ro-sat-one-association/C4TS/README.md

# C4TS
https://www.facebook.com/c4tsinspace/
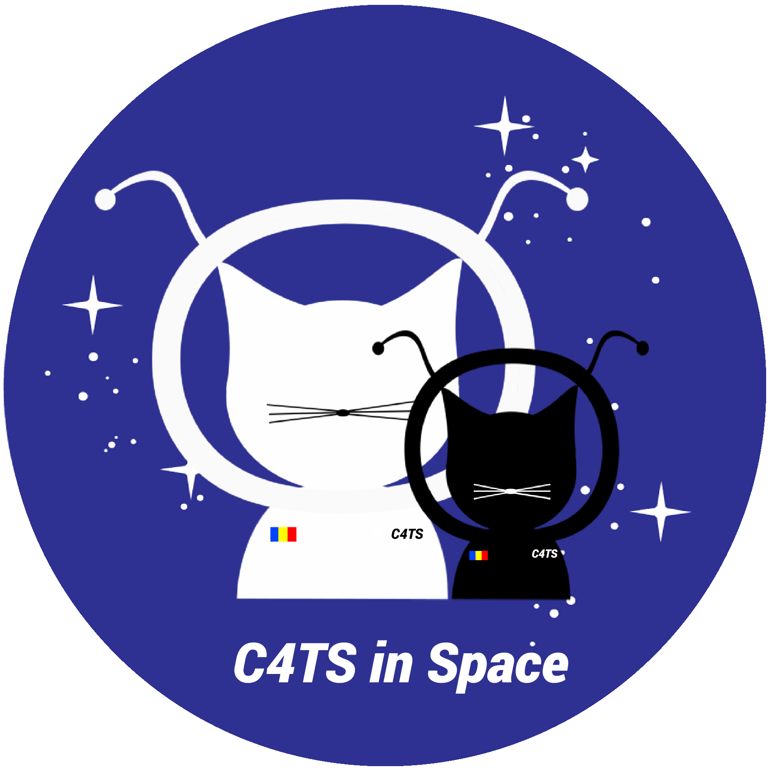
[picture p1: logo.png]
