ro-sat-one-association/C4TS/checklisturi finale/Prelansare.docx

# CHECKLIST PRE-LANSARE

1. Cameră video
2. Baterii camera
3. Setari făcute camera
4. Cameraman „permanent”
5. Telefon pentru live Facebook (Nico)
6. Delimitare loc lansare
7. Prelată (+fixare cuie)
8. Balon latex
9. Fixare gura de umplere balon + asigurare
10. Butelie cu He
11. Nacelă
12. Parașută
13. Legare nacelă de parașută
14. Legare linie de balon
15. Legare linie asigurare si determinare Nozzle Lift (cântar)
16. Verificare legături

Semnatura celui ce a facut verificarile și numele în clar:
