ro-sat-one-association/C4TS/checklisturi finale/inventar.docx

# INVENTAR GENERAL

Reductor de gaz
Gură de umplere balon
Furtun reductor-gură
Multimetru
Patent
Unealtă tăiere A-ȚĂ?!
APRSDroid (Daniel)
Raportoare mari
Elastic antenă
Busolă (Nico)
Hotspot mobil (Radu)
Laptop 1, 2, (3)
RTL-SDR Pi
RTL-SDR monitorizare
Reflectometru
Baofeng
GoPro
Cântar
Bandă teflon
Apă cu săpun
Apă
Semințe
Șlapi
Card cameră internă
Card cameră externă
Card GoPro
Incarcator USB
Cablu USB 1
Cablu USB 2
Prelungitor
HW Balon
Baterie principală balon
Rezervă baterie balon
Baterie GSM
Cameră internă Sony
Cameră externă
Folie alimentară
Coliere plastic
Legături nacelă-balon
Antena de pe balon-nacelă
Balon Latex
Parașută
Suport antenă
Butelie He
Prelată
Scaun x3
Masă
2 tăruși
Umbrelă
Generator
Antenă
