ro-sat-one-association/C4TS/checklisturi finale/Lansare.docx

# CHECKLIST LANSARE

1. Pornește hardware-ul balonului
2. Așteaptă de la stația de sol confirmarea primirii mesajelor APRS și SMS
3. Așteaptă de la stația de sol confirmarea funcționării corecte a senzorilor
4. Verificare robineți reductori He ( inchis)
5. Montare reductor
6. Deschidere robinet înalta presiune
7. Verificare etanseitate ( + corectare in caz că trebuie )
8. Conectare butelie He la gura de umplere
9. Deschidere robinet joasă presiune
10. Verificare etanseitate la furtune și la gura de umplere
11. Umple balonul cu He
12. Verificare Nozzle Lift
13. Etanșarea gurii balonului
14. Extragere gura de umplere
15. Finalizarea legaturii de etanșarea si reverificarea legaturii liniei de payload
16. Reconfirmare de la stația de sol a funcționării corecte a comunicațiilor și senzorilor
17. Lansează !

Semnatura celui ce a facut verificarile și numele în clar:
