ro-sat-one-association/C4TS/scheme/1.png

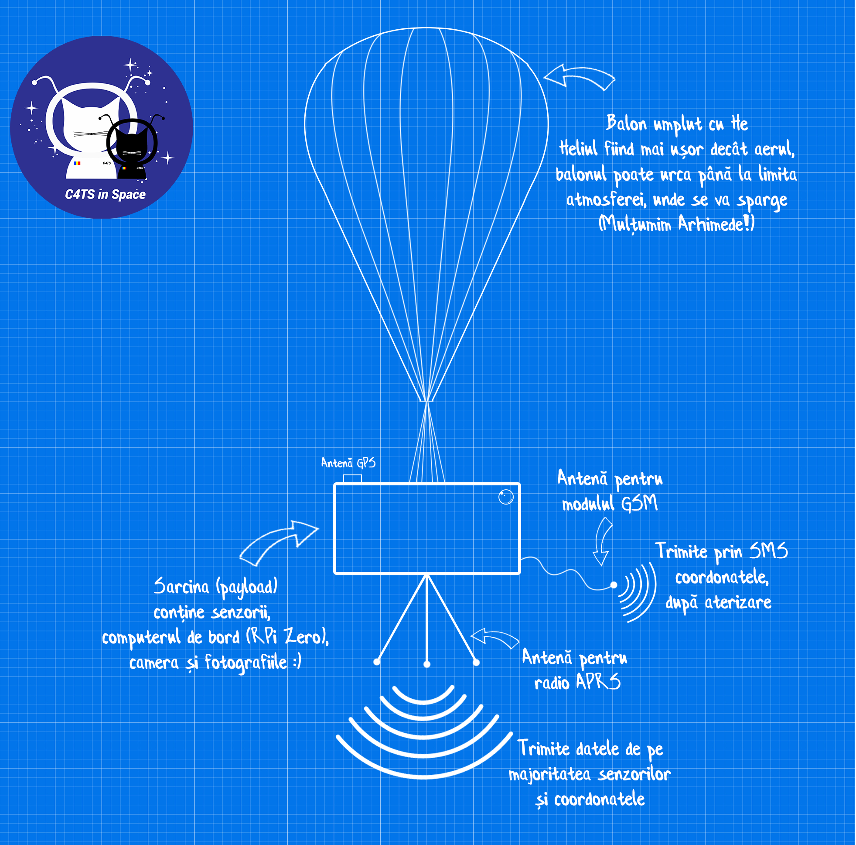
scheme/1.png
