ro-sat-one-association/C4TS/scheme/HABPCB/gsm-gpsb.png

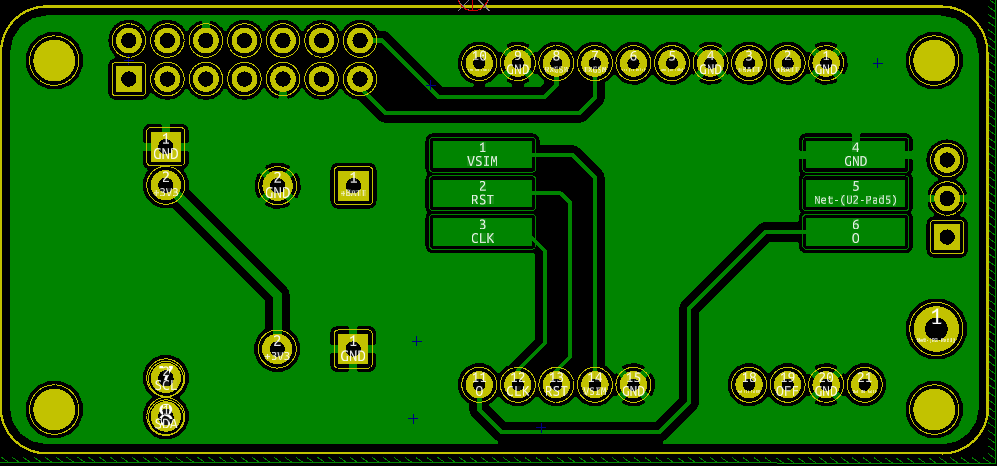
scheme/HABPCB/gsm-gpsb.png
