ro-sat-one-association/C4TS/scheme/HABPCB/gsm-gpsf.png

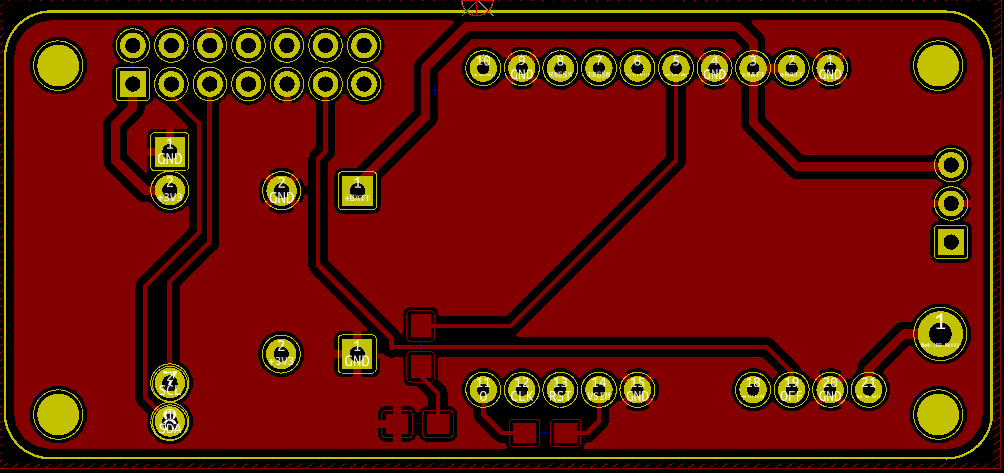
scheme/HABPCB/gsm-gpsf.png
