ro-sat-one-association/C4TS/scheme/HABPCB/promini hx1b.png

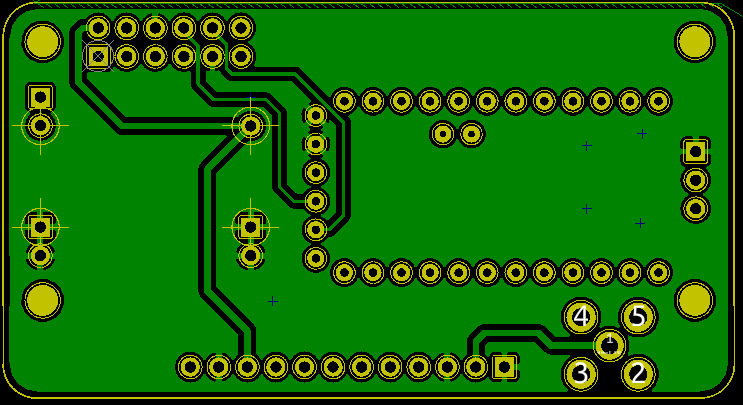
scheme/HABPCB/promini hx1b.png
