ro-sat-one-association/C4TS/scheme/HABPCB/promini hx1f.png

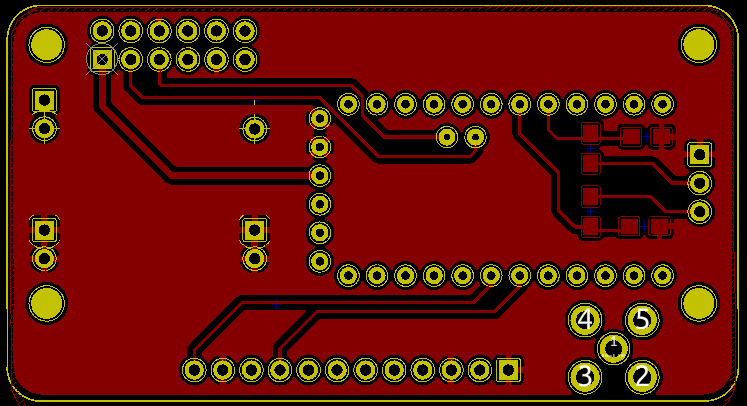
scheme/HABPCB/promini hx1f.png
