ro-sat-one-association/C4TS/scheme/HABPCB/sensorsb.png

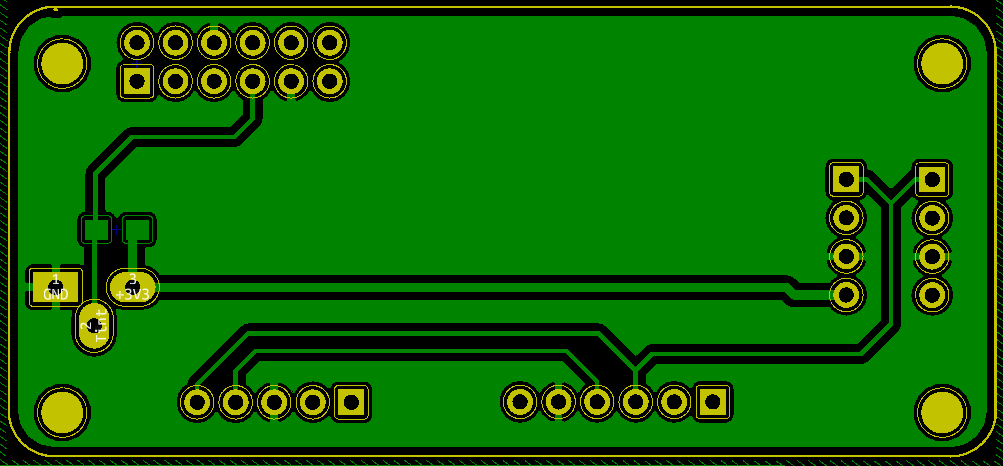
scheme/HABPCB/sensorsb.png
