ro-sat-one-association/C4TS/scheme/HABPCB/sensorsf.png

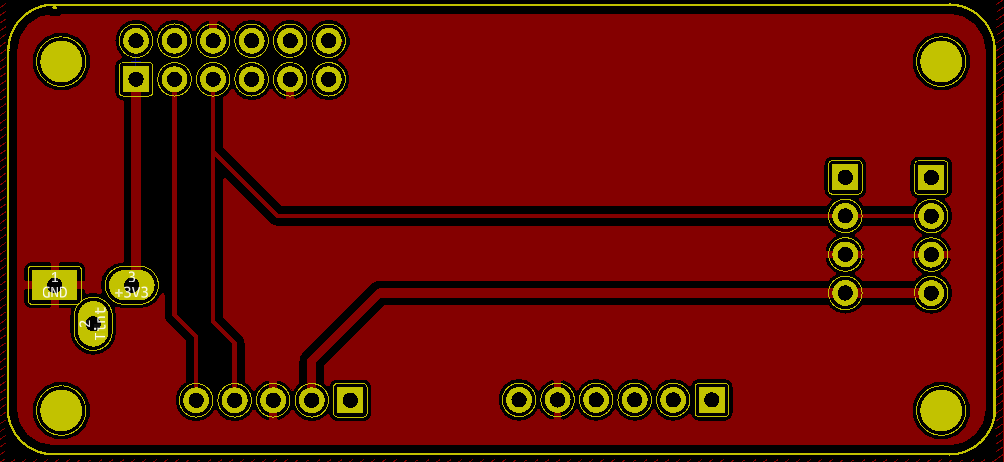
scheme/HABPCB/sensorsf.png
