ro-sat-one-association/C4TS/scheme/hardware.png

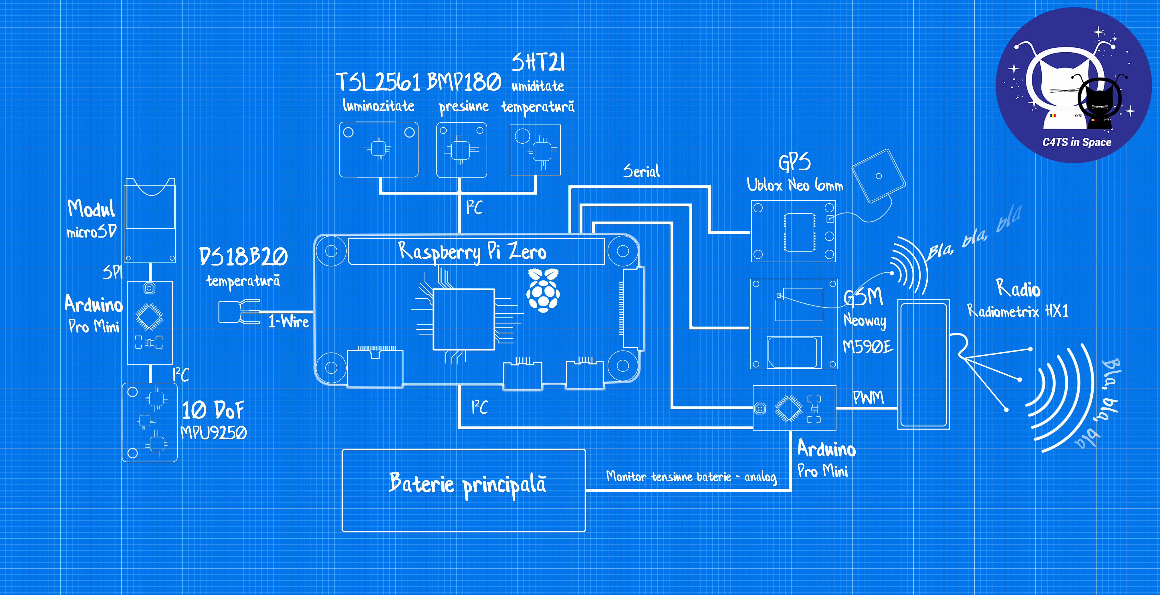
scheme/hardware.png
