ro-sat-one-association/C4TS/scheme/Noaptea cercetatorilor/1.png

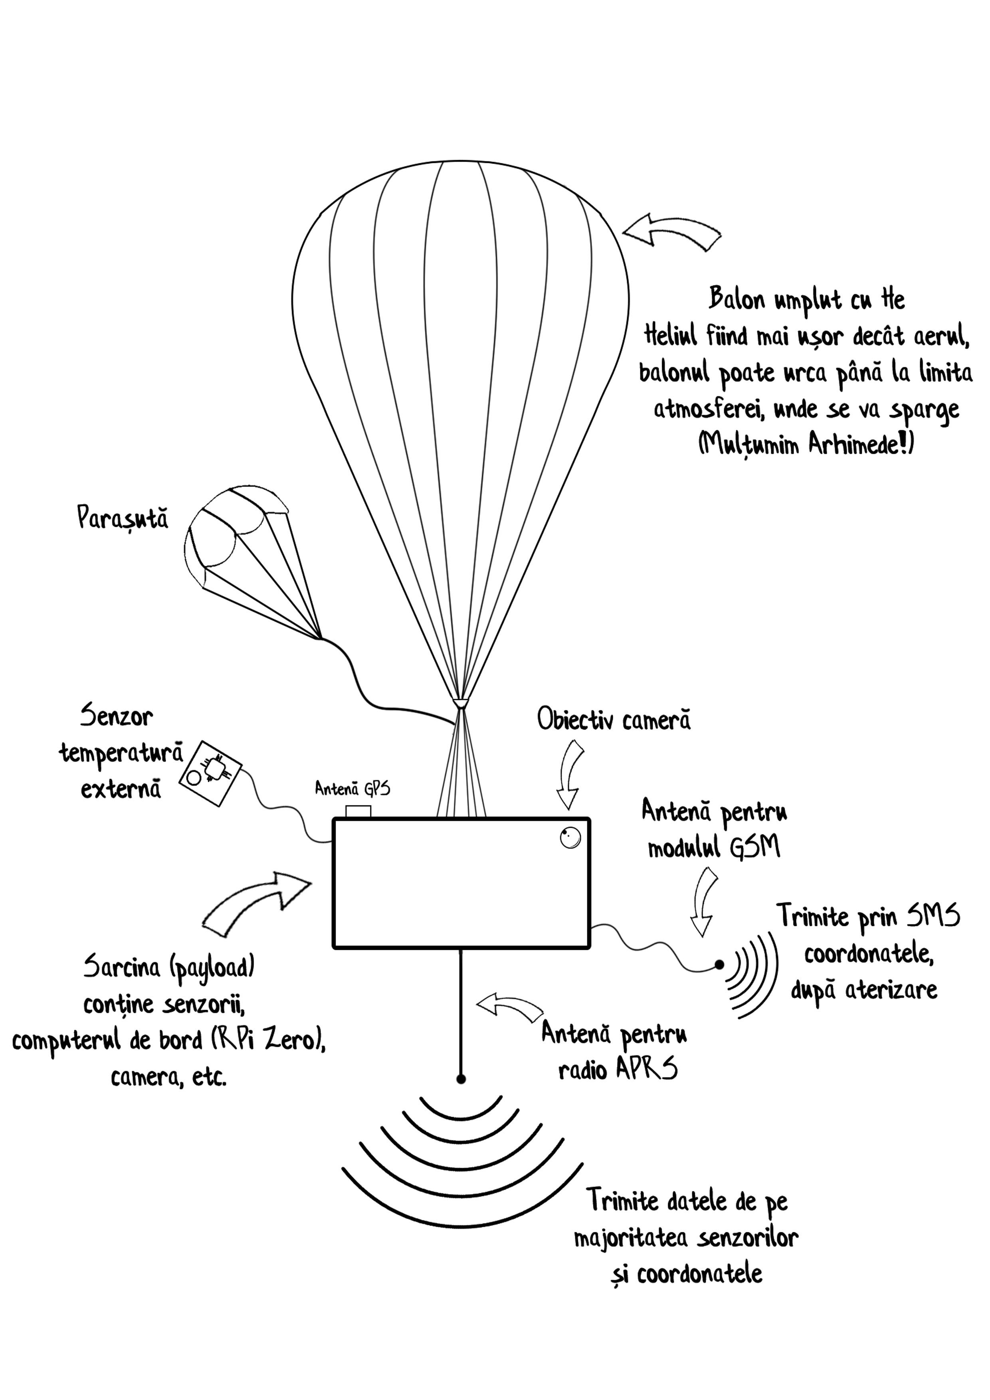
scheme/Noaptea cercetatorilor/1.png
