ro-sat-one-association/C4TS/scheme/Noaptea cercetatorilor/fata.png

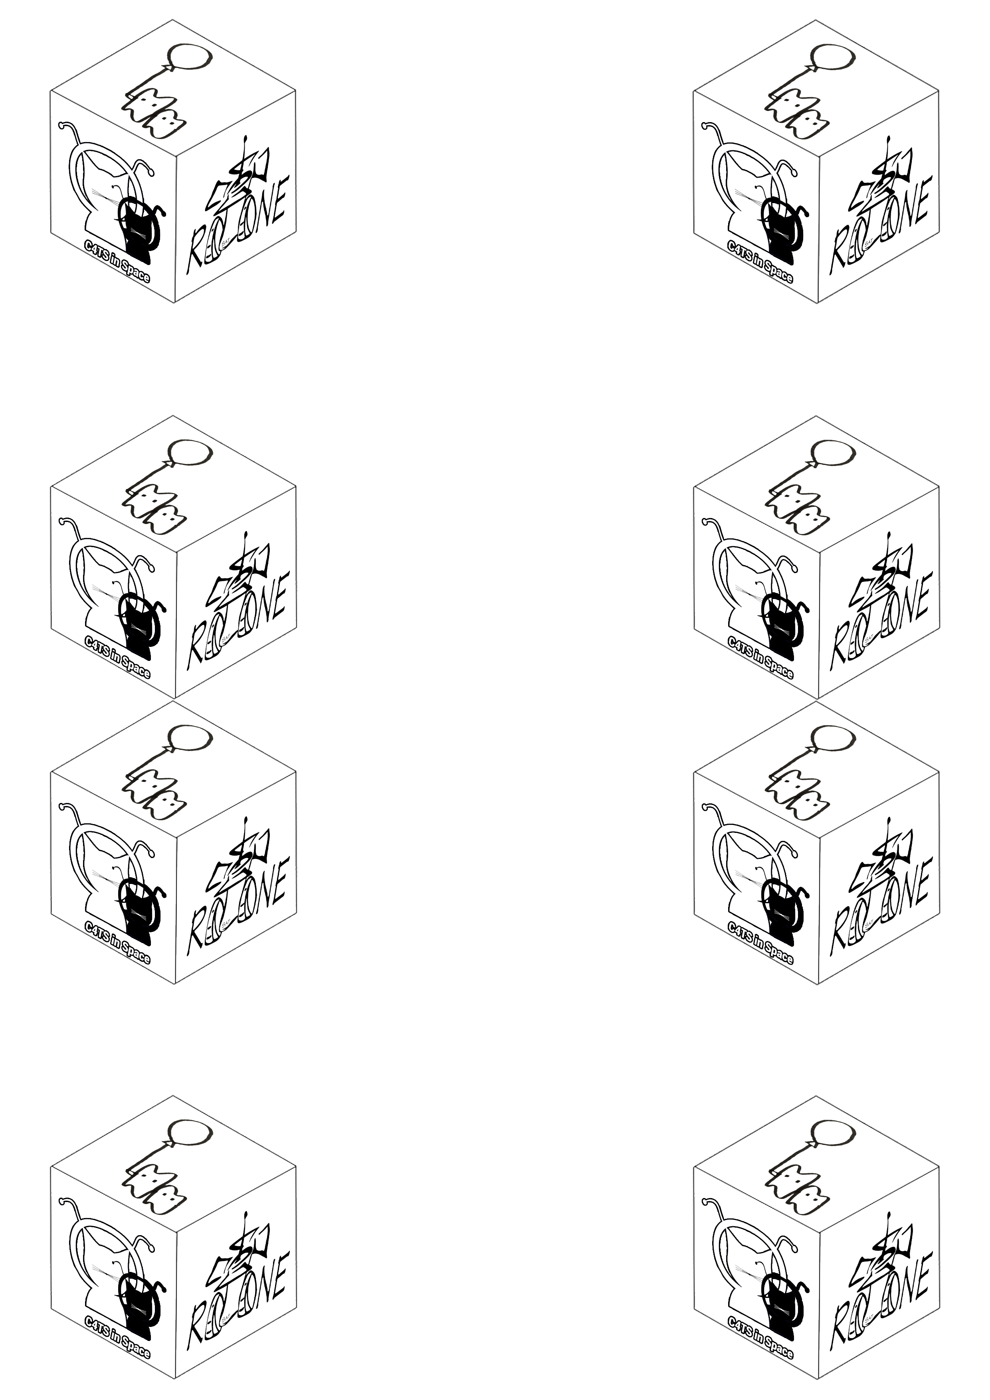
scheme/Noaptea cercetatorilor/fata.png
