ro-sat-one-association/C4TS/scheme/Noaptea cercetatorilor/hard.png

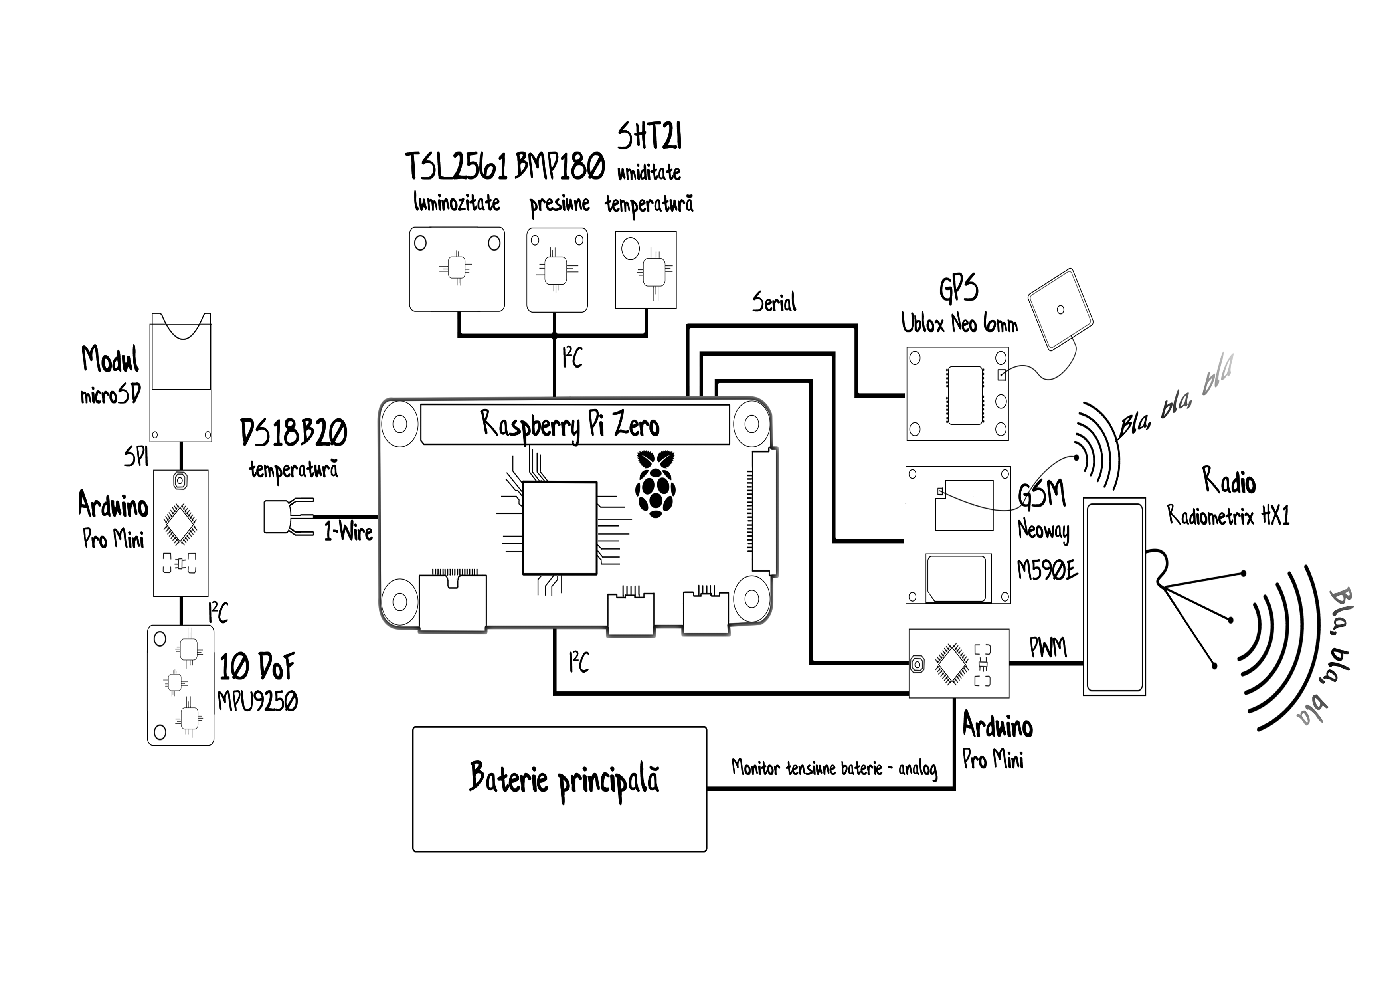
scheme/Noaptea cercetatorilor/hard.png
