ro-sat-one-association/C4TS/scheme/placi/gsm-gpsf.png

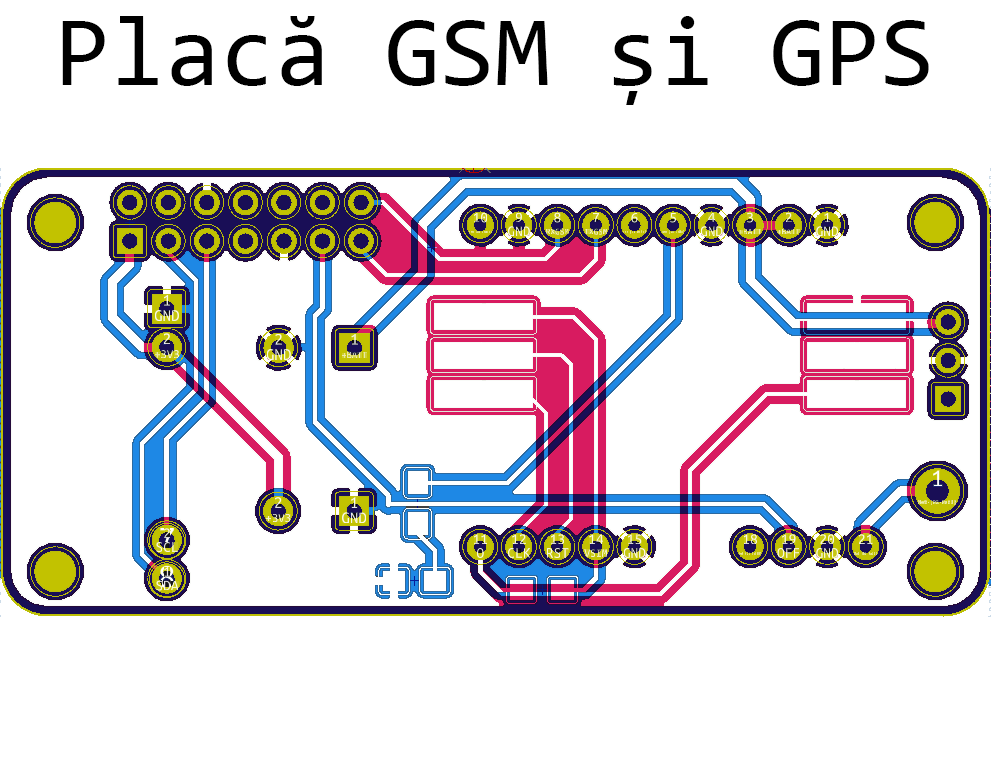
scheme/placi/gsm-gpsf.png
