ro-sat-one-association/C4TS/scheme/placi/promini hx1f.png

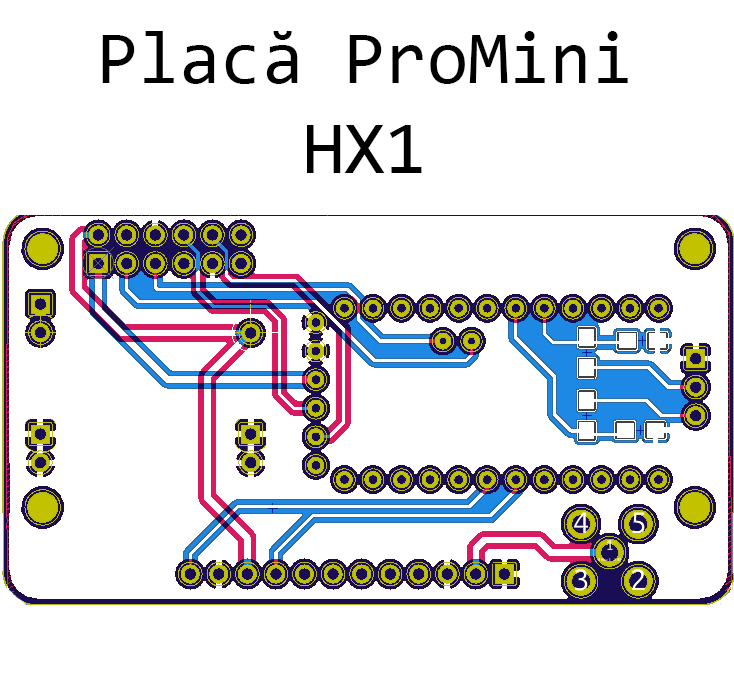
scheme/placi/promini hx1f.png
