ro-sat-one-association/C4TS/scheme/schema detaliata cod.png

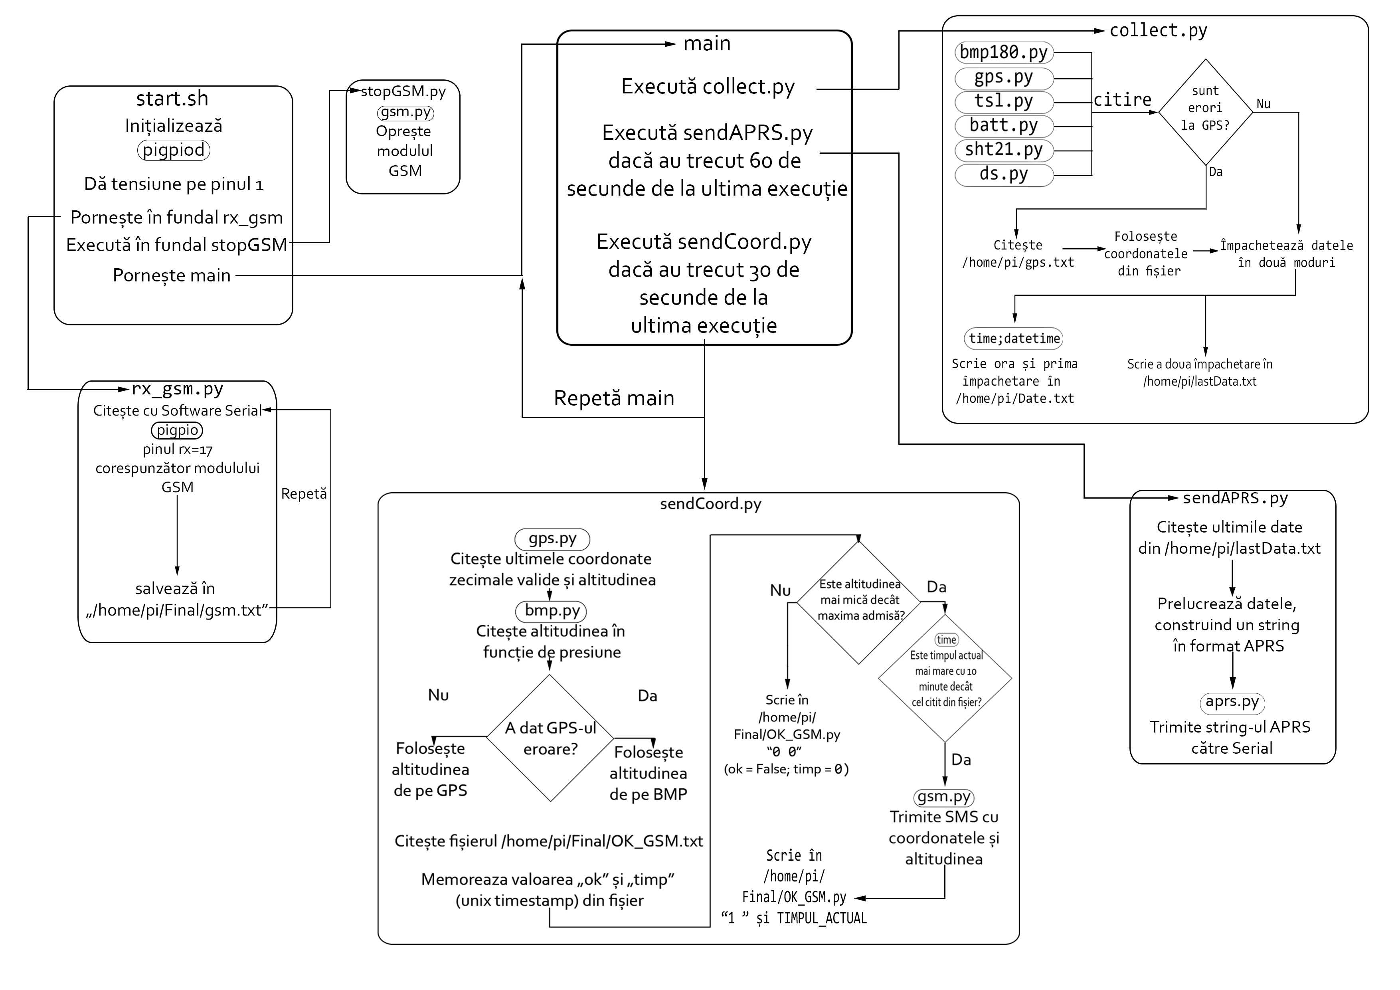
scheme/schema detaliata cod.png
