ro-sat-one-association/C4TS/scheme/schema_comunicatii.png

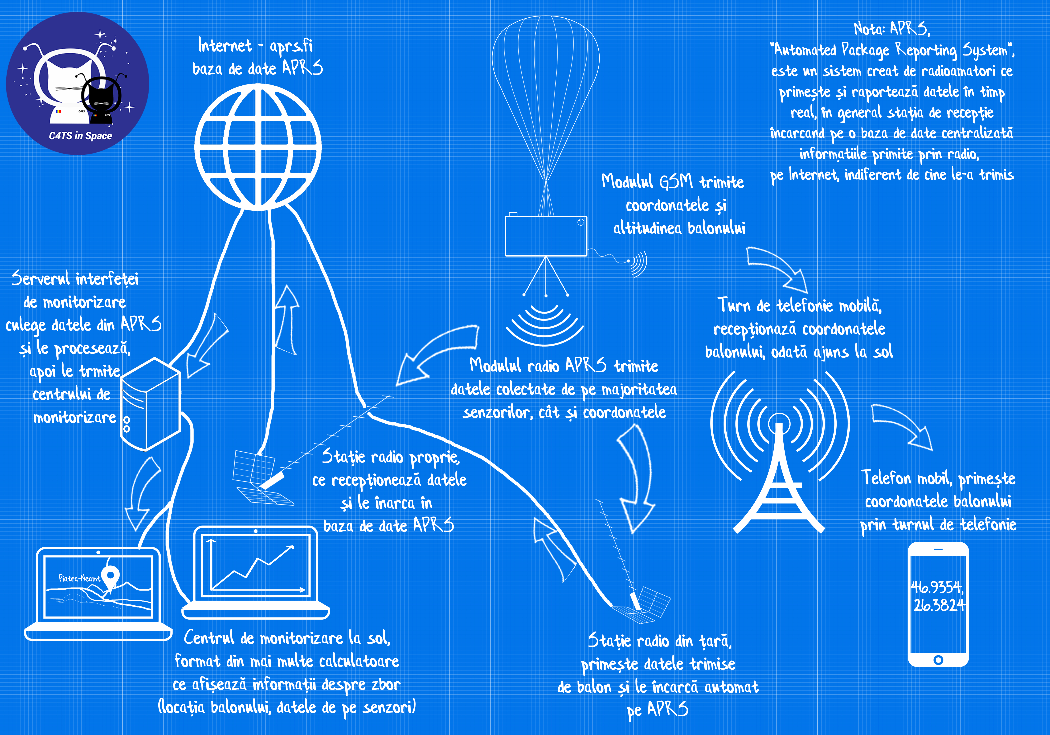
scheme/schema_comunicatii.png
