ro-sat-one-association/C4TS/tracker/tracker.kicad_pcb

## KiCad design tracker/tracker.kicad_pcb (2018-05-26, last stored version)

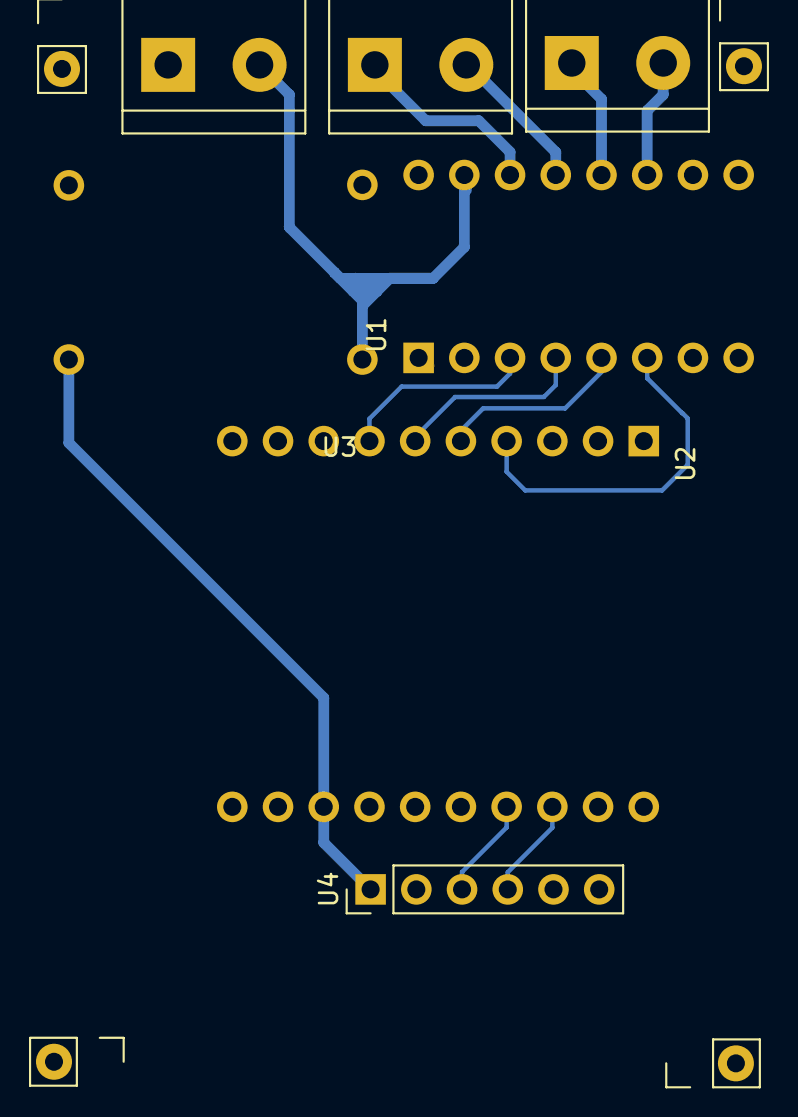
[picture p30: board tracker.kicad_pcb from above]

Board: 2 copper layers, 7 parts (0 on the bottom side), 13 nets.

Parts:
J1: Conn_01x02; TerminalBlock_bornier-2_P5.08mm
M1: Motor_DC -A-; TerminalBlock_bornier-2_P5.08mm
M2: Motor_DC2 -B-; TerminalBlock_bornier-2_P5.08mm
U1: DRV8833
U2: ESP8266(3.3); ESP8266
U3: pwr_reg
U4: M10DOF; Pin_Header_Straight_1x06_Pitch2.54mm

Connections:
+3V3: U2.19, U3.4, U4.1
+BATT: J1.2, U1.15, U3.1
GND: J1.1, U1.16, U2.10, U2.17, U2.18, U3.2, U3.3, U4.2
unnamed: M1.1, U1.12
unnamed: M1.2, U1.11
unnamed: M2.1, U1.14
unnamed: M2.2, U1.13
unnamed: U1.3, U2.7
unnamed: U1.4, U2.6
unnamed: U1.5, U2.5
unnamed: U1.6, U2.4
unnamed: U2.23, U4.3
unnamed: U2.24, U4.4
