ro-sat-one-association/C4TS/(commit log)

2017-11-03 RPi -> Arduino Pro Mini Driver -> APRS Radio
2017-11-05 Basic driver changes
2017-12-19 cripturi de camera:{
2018-01-28 Monitorizare baterie + Driver radio
2018-02-03 Driver functional
2018-03-05 Procedura de verificare a senzorilor la pornire + APRS
2018-03-05 + Camera check
2018-03-26 Tracker + Cod Busola MPU + SoftwareSerial Rx/Tx script
    [_saved_tracker.sch, tracker.kicad_pcb, tracker.sch]
2018-04-29 Separat colectarea de trimitere, testat cazurile de eroare, TODO: vezi cum stabilesti starea camerei
2018-05-04 Inceput de cod final
    [_saved_tracker.sch]
2018-05-19 Am adaugat trackerul
    [tracker.kicad_pcb, tracker.v2.kicad_pcb]
2018-06-02 SMS instant la reintrarea in altitudine
2018-06-08 Primire de date direct de pe serverele aprs, inceput
2018-06-18 Modificari la procesarea de sol, parola suplimentara
2018-06-18 script alternativ pentru luat datele de pe .fi + script adaugare toate datele
2018-07-01 temperatura externa = SHT, nu BMP in pana mea
2018-07-12 Curatenie si aliniere antena
    [tracker.kicad_pcb, tracker.sch, tracker.v2.kicad_pcb]
2018-09-22 Date si scheme
    [analiza-c4ts.xlsx]
2018-11-23 Incercare documentatie (in lucru)
    [Date.xlsx, analiza-c4ts.xlsx]
